KrisKasprzak/ESP32_AI-Camera/Images/Camera_PCB.jpg

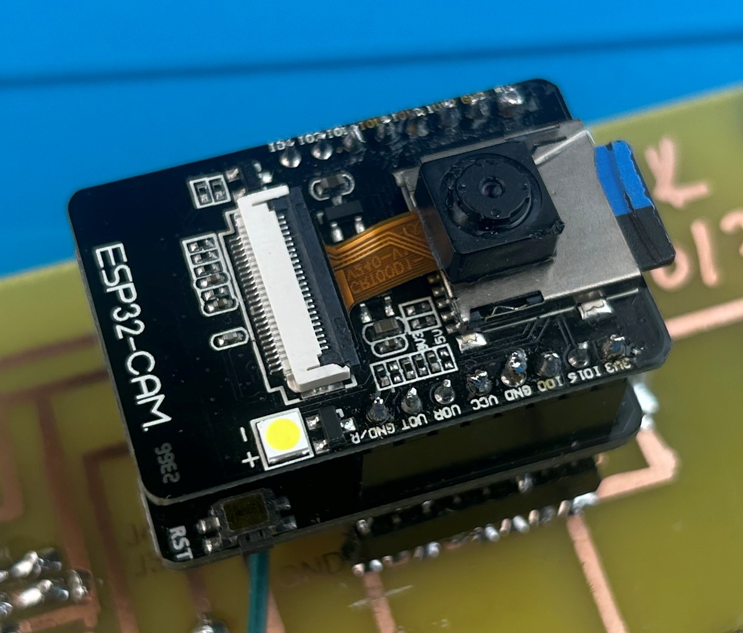
Images/Camera_PCB.jpg
