KrisKasprzak/ESP32_AI-Camera/(commit log)

2026-10-23 Add schematic image to README
2026-10-23 Increase schematic image width to 640px
    Updated schematic image size in README.
2026-10-23 Increase schematic image width in README
2026-10-23 Update schematic image width in README
    Adjusted the width of the schematic image in the README.
2026-10-23 Update schematic image width in README
